vakovalskii/rc-pr-1/docs/photos/car.jpg

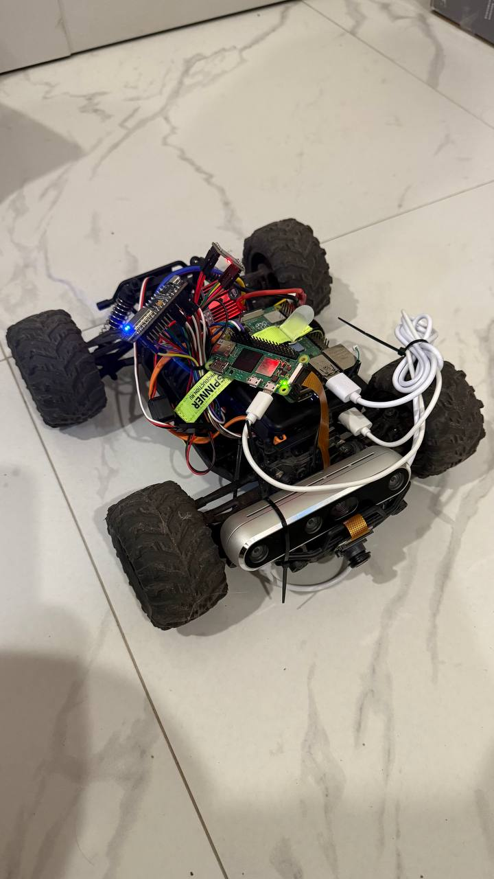
docs/photos/car.jpg
