vakovalskii/rc-pr-1/docs/photos/pult_osd_split.jpg

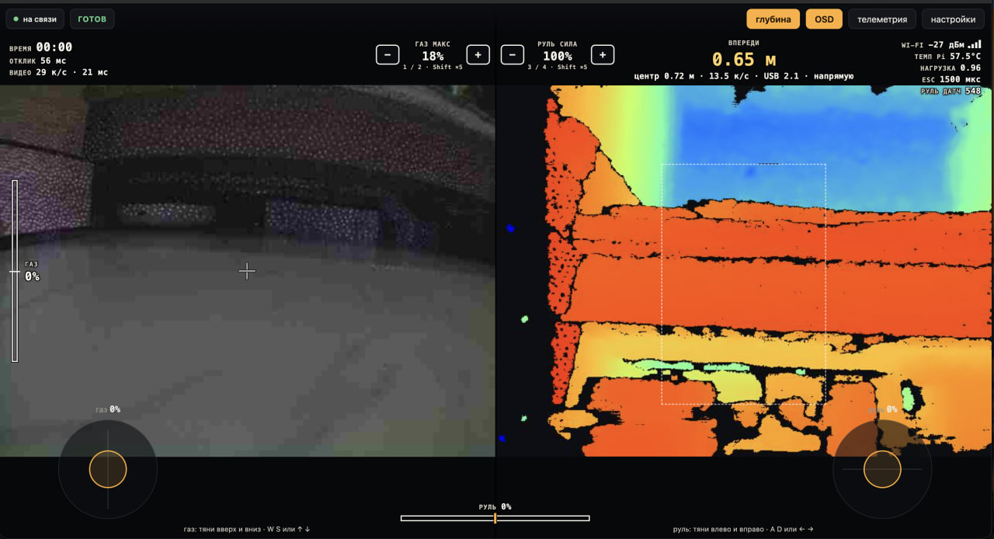
docs/photos/pult_osd_split.jpg
