vakovalskii/rc-pr-1/docs/BOM.md

# Железо: что есть и что покупаем

Цены и сроки — Ozon на 1 сентября 2026. Корзина собрана, заказ по частям.

## Что уже есть

| что | роль в проекте | заметки |
|---|---|---|
| Багги **HW8808RD** 1:16, 2.4 ГГц | шасси | родной пульт сломан, штатная плата выкидывается. 2 провода на коллекторный мотор. **Серва руля 5-проводная** (чёрный, красный, жёлтый, белый, коричневый): моторчик + потенциометр без своей электроники — напрямую ШИМ не понимает, нужен переходник 5→3 провода или замена на стандартную серву |
| Raspberry Pi 4 (4 ГБ по `free`) | голова на борту вместо Zero 2W | камера OV5647 160° в разъём CAMERA шлейфом из коробки камеры; питание 5.1 В 3 А, от BEC нельзя |
| Huawei 4G-модем с раздачей Wi-Fi | связь: едет **на машинке** | ESP32/Pi в 20 см от точки доступа, дальность = покрытие оператора. Разъём антенны (TS9 или CRC9) — посмотреть под крышкой |
| Mikrotik mAP lite | дома, не на борту | один радиомодуль не тянет одновременно точку доступа для ESP и станцию до модема |
| Mac mini (дом) + MacBook Pro M1 Pro 32 ГБ | хост вычислений, стенд | M1 Pro тянет COLMAP и обучение маленьких сетей; 3DGS лучше на 4090 |
| Парк GPU-серверов (2× 4090 48 ГБ ×2, 4090 24 ГБ, 2× A4500, 3080 Ti) | тяжёлое: сплаты, VLM | боевые машины под сервисами, занимать по договорённости |
| VPS с публичным IP | релей, если домашний интернет за CGNAT | |
| Телефон | экран пульта (веб-приложение) | на машинку не ставится |
| Паяльник | | канифоль и пинцет — в корзине |

## Корзина Ozon — 17 позиций, 22 869 ₽

| # | что | цена | приезд | зачем |
|---|---|---|---|---|
| 1 | ESP32-CAM с внешней антенной + плата-программатор USB | 1 176 ₽ | 3 сент | первый мозг: MJPEG-стрим и ШИМ; потом — реалтайм-контроллер моторов по UART от Pi |
| 2 | ESC **HG1060** 60A, brushed, реверс, BEC 5.35 В/3 А, T-plug | 1 182 ₽ | 7 сент | ходовой регулятор; BEC питает серву и ESP |
| 3 | Аккумулятор Li-ion 7.4 В 5000 мАч, T-plug | 1 422 ₽ | 2 сент | ходовая батарея |
| 4 | Зарядное B3 Pro балансирное | 945 ₽ | 2 сент | под ходовую батарею |
| 5 | Raspberry Pi Zero 2 W | 7 933 ₽ | 5 сент | второй этап: H.264 с CSI-камеры, WireGuard, GPS |
| 6 | Камера OV5647 CSI, 160° | 1 057 ₽ | 7 сент | для Pi; аппаратный H.264 работает только с CSI |
| 7 | Шлейф FFC под Pi Zero, 30 см | 376 ₽ | 7 сент | |
| 8 | microSD Samsung EVO Plus 64 ГБ (MB-MC64HA/RU), **A1** | 1 333 ₽ | 4 сент | под Pi; линуксу нужен A1, A2 бесполезен |
| 9 | microSD Smartbuy 32 ГБ Class 10 | 735 ₽ | 2 сент | под ESP (пишет JPEG подряд, A1 не нужен) |
| 10 | Корпус-повербанк DIY 4× 18650, 22.5 Вт, Type-C | 642 ₽ | 13 сент | питание Pi и модема **отдельно от BEC** |
| 11 | Банки 18650 30Q 3000 мАч × 4 | 1 752 ₽ | 4 сент | в повербанк; высокотоковость не нужна (0.5 А на банку) |
| 12 | GPS NEO-M8N | 1 133 ₽ | | для поля первичнее визуального SLAM |
| 13 | Набор: припой + пинцет + канифоль | 198 ₽ | 2 сент | |
| 14 | Провода Dupont 20 см, 120 шт | 210 ₽ | 2 сент | |
| 15 | Ящик СИБРТЕХ 21″ 530×290×280, органайзеры | 1 775 ₽ | 2 сент | внутри ~50×26×25 — багги влезает по ширине колёс |
| 16–17 | разъёмы XT60 мама-папа | | | питание на нормальном силовом стандарте |

Ошибка первого заказа: **ESC 30A за 809 ₽ — для бесколлекторных моторов авиамоделей**, в багги
коллекторный мотор с реверсом. Не использовать, заменён на HG1060.

## Проверить дома / докупить копеечное

| что | зачем | ~цена |
|---|---|---|
| Подставка под машинку | колёса в воздухе — калибровать газ и руль без побега со стола | 300 ₽ |
| Липучка-ремень для батареи | штатный держатель под другой аккумулятор | 150 ₽ |
| Стяжки + двусторонний скотч 3M VHB | крепить платы до печати корпуса | 300 ₽ |
| Термоусадка | единственная спайка на моторе | 200 ₽ |
| Мультиметр | прозвонить питание до первого включения | 800 ₽ |

## Потом, по результатам первых выездов

- Антенны для Huawei: TS9 5 dBi (237 ₽) или CRC9 3 dBi (235 ₽) — после 14 сентября, когда станет ясен разъём.
- Пигтейлы TS9→SMA (377 ₽) + выносные SMA-антенны, если машинку начнём ронять всерьёз.
- IMU MPU6050 (150 ₽) — GPS не знает курс стоя на месте, сращивать с гироскопом.
- 3D-печать корпуса под электронику.

## Ключевые распиновки и ограничения

- ESP32-CAM: после камеры и PSRAM свободны GPIO **13** и **14** — серва на 14, ESC на 13, ШИМ через аппаратный LEDC.
- SD-слот ESP32-CAM в 1-битном режиме занимает GPIO 2, 14, 15 — либо карта, либо два чистых ШИМ.
- Pi питать от повербанка, не от BEC: 5.35 В выше спеки USB, а серва просаживает шину.
- Pi Zero 2 W: хороший UART занят Bluetooth, для GPS нужен `dtoverlay=disable-bt`.
- GPS-антенну подальше от LTE-модема — гармоники глушат сигнал −130 дБм.
- Довесок на шасси ~700–790 г при собственном весе ~1 кг: тяжёлое низко и между осями.
