vakovalskii/rc-pr-1/docs/wiring/README.md

# Проводка борта: Pi Zero 2 W + ESP8266 + DRV8837

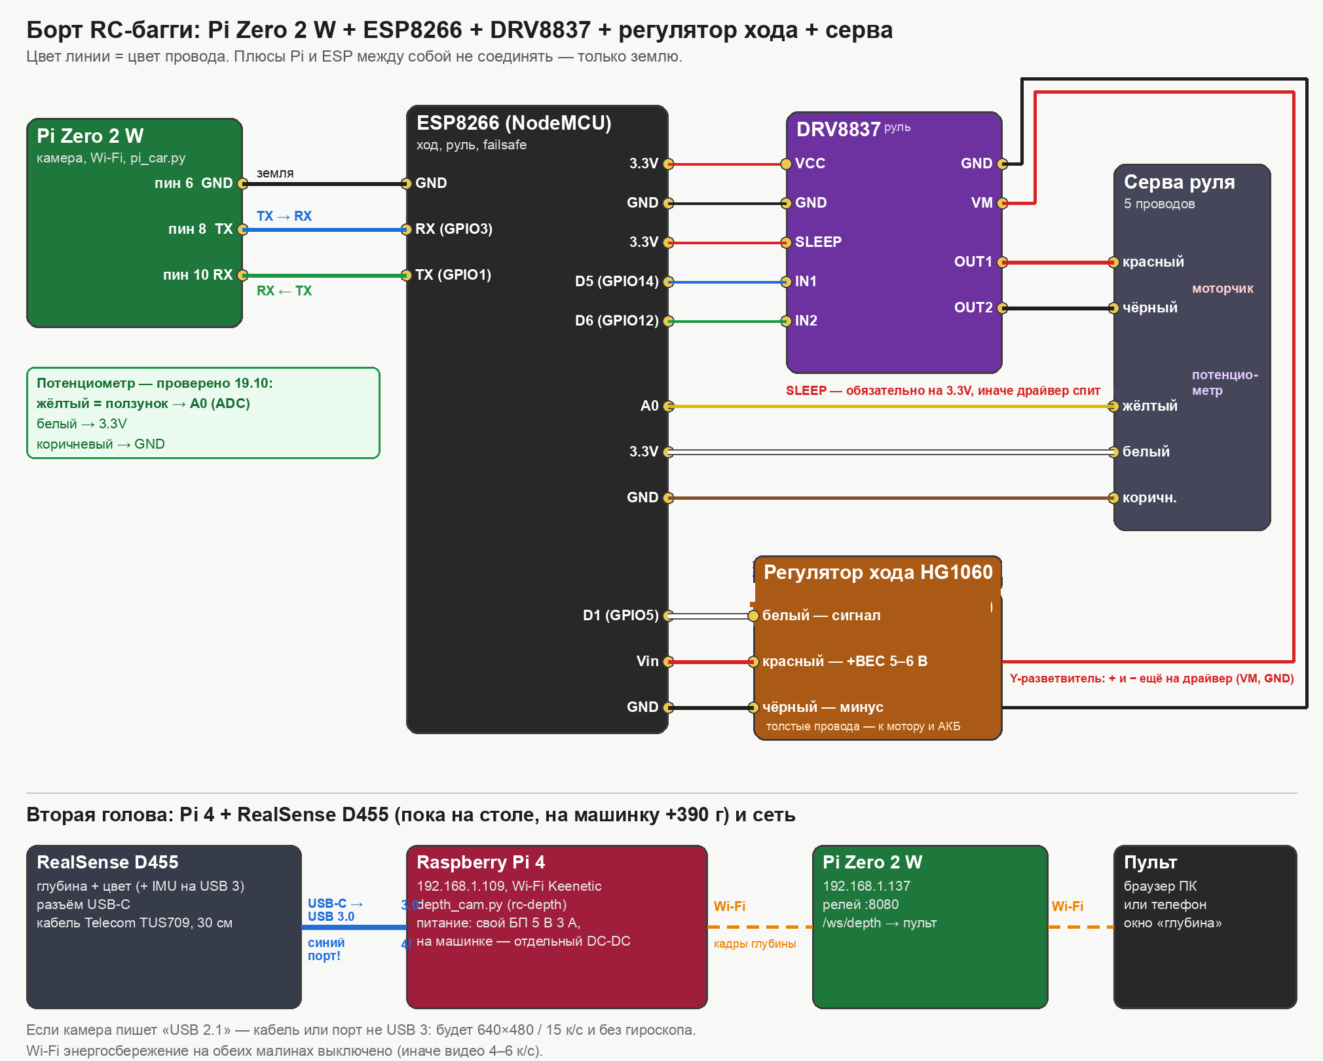
[picture p4: docs/wiring/board_full.png]
Общая схема


Pi Zero 2 W — камера и сеть. ESP8266 (NodeMCU, `firmware/rc_esp`) — ход, руль по
потенциометру и failsafe 300 мс. Связь между ними — UART, команды `c,id,руль,газ`.

## Pi Zero 2 W → ESP8266 (UART)

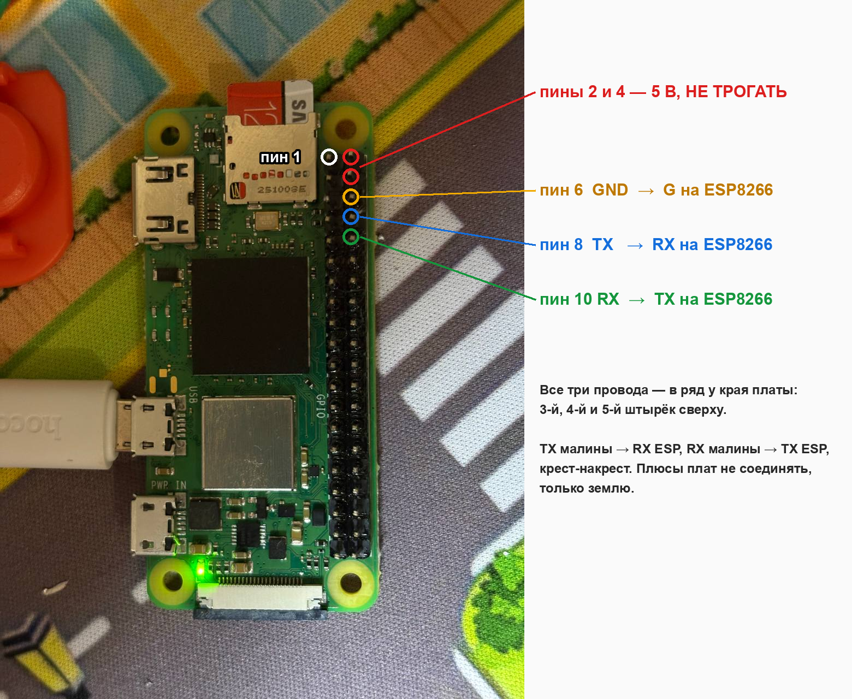
[picture p5: docs/wiring/pi_zero_uart.png]
Pi Zero

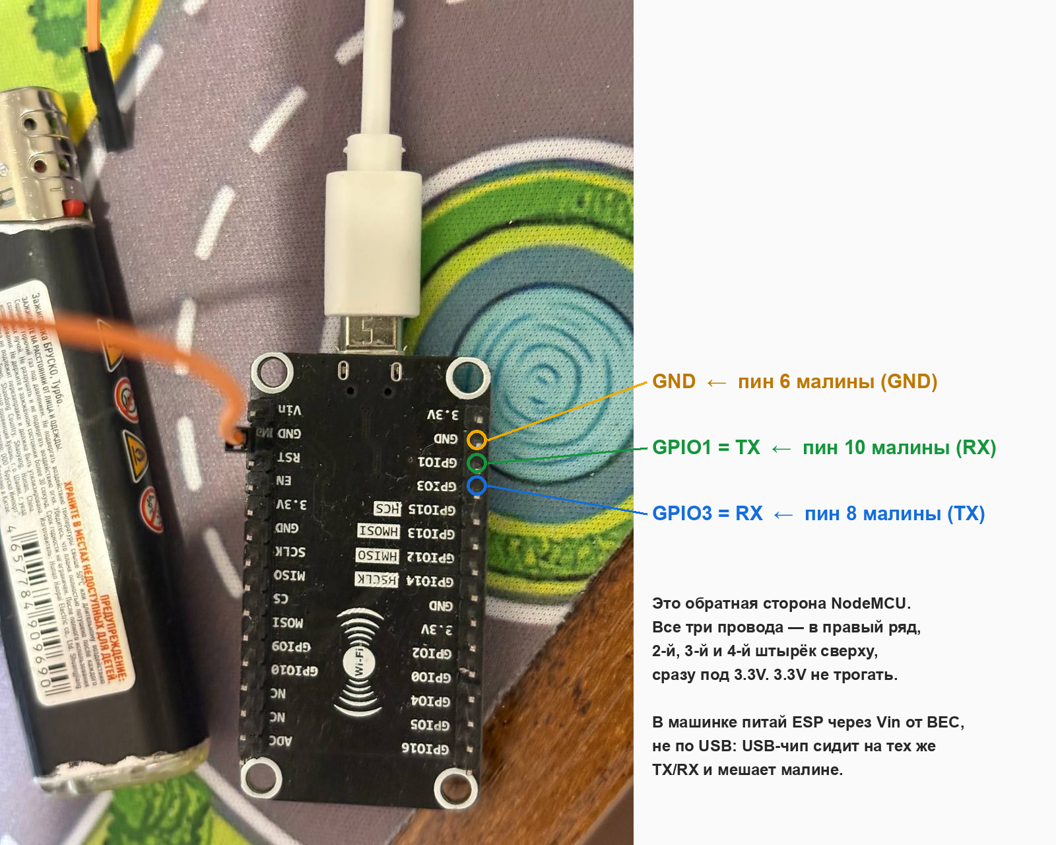
[picture p6: docs/wiring/esp_uart.png]
ESP8266, UART


| Pi Zero | ESP8266 |
|---|---|
| пин 6, GND | GND (правый ряд на обороте, 2-й сверху) |
| пин 8, GPIO14 TX | GPIO3 RX (4-й) |
| пин 10, GPIO15 RX | GPIO1 TX (3-й) |

На Zero: `enable_uart=1`, `dtoverlay=disable-bt`, консоль убрана из `cmdline.txt`,
порт `/dev/serial0 -> ttyAMA0`. Плюсы плат не соединяются, только земля.

## Регулятор хода (HG1060, 3 провода)

| Провод регулятора | Куда |
|---|---|
| белый — сигнал | GPIO5 / D1 ESP |
| красный — BEC +5–6 В | Vin ESP и VM драйвера |
| чёрный — минус | GND ESP и правый GND драйвера |

## Серва руля (5 проводов, своей электроники нет)

| Провод сервы | Что это | Куда |
|---|---|---|
| красный, чёрный | моторчик | OUT1, OUT2 драйвера |
| жёлтый | ползунок потенциометра | A0 (ADC) |
| белый | край потенциометра | 3.3V ESP |
| коричневый | край потенциометра | GND ESP |

## DRV8837 → ESP8266 и машинка

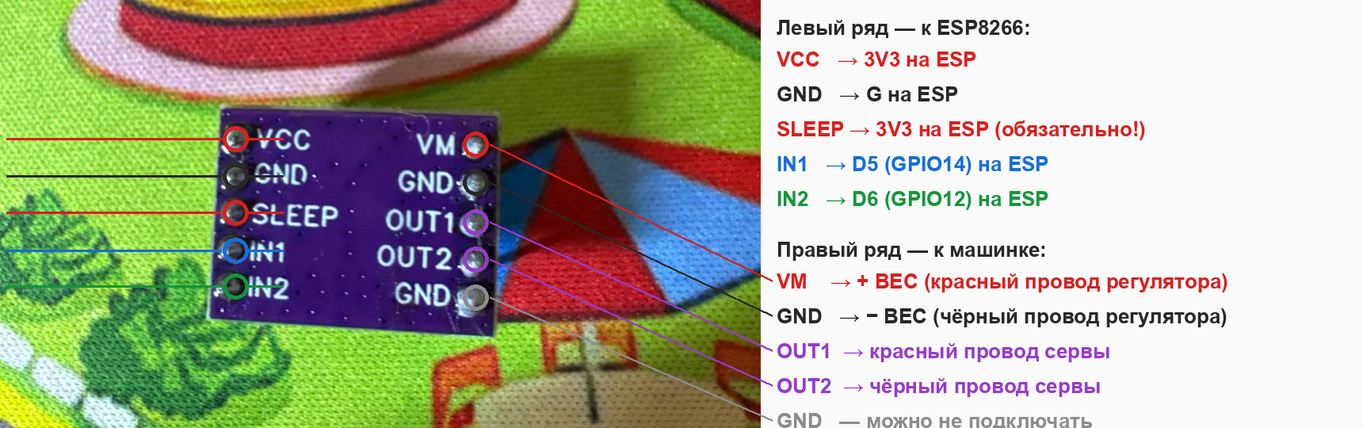
[picture p7: docs/wiring/drv8837_wiring.png]
DRV8837

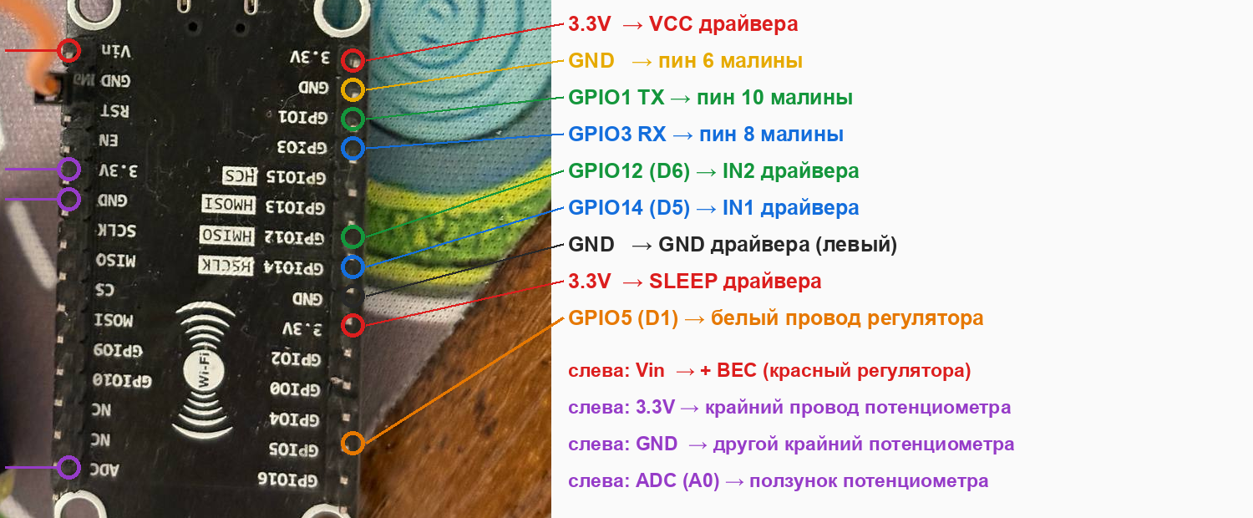
[picture p8: docs/wiring/esp_full_wiring.png]
ESP8266, всё


| DRV8837 | Куда |
|---|---|
| VCC | 3.3V ESP |
| GND (левый) | GND ESP |
| SLEEP | 3.3V ESP — без этого драйвер спит (на плате подтяжка к GND) |
| IN1 | D5 / GPIO14 |
| IN2 | D6 / GPIO12 |
| VM | + BEC регулятора (красный) |
| GND (правый) | − BEC регулятора (чёрный) |
| OUT1 / OUT2 | красный / чёрный провод сервы (полярность меняется командой `inv`) |

Потенциометр сервы (жёлтый/белый/коричневый): ползунок → A0 (ADC), крайние → 3.3V и GND.
Ползунок — тот провод, у которого сопротивление к двум другим меняется при повороте колёс.

ESP в машинке питается от BEC через Vin. По USB на столе — можно, но USB-чип NodeMCU
сидит на тех же TX/RX и может мешать малине.

## Фото

- `../photos/car.jpg` — машинка в сборе: Pi Zero 2 W + ESP8266 + DRV8837 сверху, Pi 4 под ними, RealSense D455 и OV5647 спереди.
- `../photos/pult_osd_split.jpg` — пульт: FPV слева (29 к/с, 21 мс), глубина справа напрямую с Pi 4, OSD с газом и рулём.
- `../photos/fpv_first_test.jpg` — первый тестовый кадр камеры Zero.

## Датчик Холла на задний кардан (одометрия)

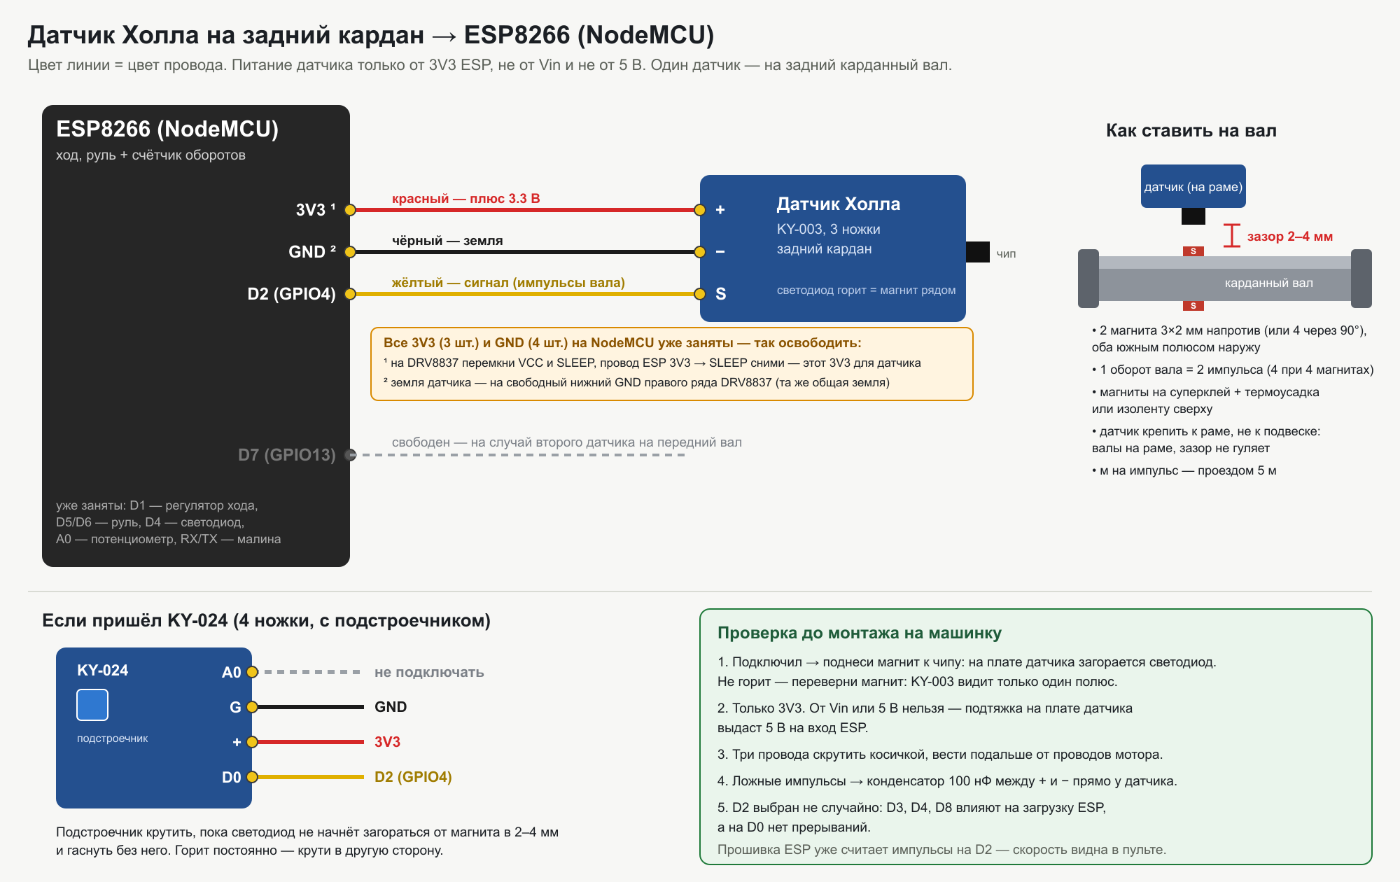
[picture p9: docs/wiring/hall_sensors.png]
Датчик Холла


| Датчик | Куда на ESP |
|---|---|
| + | 3V3 (только 3.3 В) |
| − | GND |
| S (KY-003) / D0 (KY-024) | D2 / GPIO4 (D7 / GPIO13 оставлен под второй датчик на передний вал) |

Два магнита 3×2 мм на задний кардан напротив друг друга (или 4 через 90°), южным полюсом наружу, зазор 2–4 мм — 2 (4) импульса на оборот.
