vakovalskii/rc-pr-1/docs/wiring/pi4_pins.html

# Pi 4: куда втыкать провода с Zero

Вид как на фото: Ethernet и USB слева, пин 1 справа. Нижний ряд — чётные пины, у края платы. Вентиляторы на 4 и 6 не трогать.

Схема гребёнки Pi 4 с подключением ESP8266, вентиляторов, BNO085 и GPS

Пин Pi 4 | Куда на ESP | Зачем
14 | GND | земля (пин 6 занят вентилятором)
8 | GPIO3 · RX | команды с Pi на ESP
10 | GPIO1 · TX | телеметрия с ESP на Pi
11 | RST | только для прошивки
13 | GPIO0 · D3 | только для прошивки

Питание ESP — от BEC регулятора (Vin), как было. Перетыкать при выключенном питании.
