vakovalskii/rc-pr-1/docs/wiring/esp_flash_via_zero.png

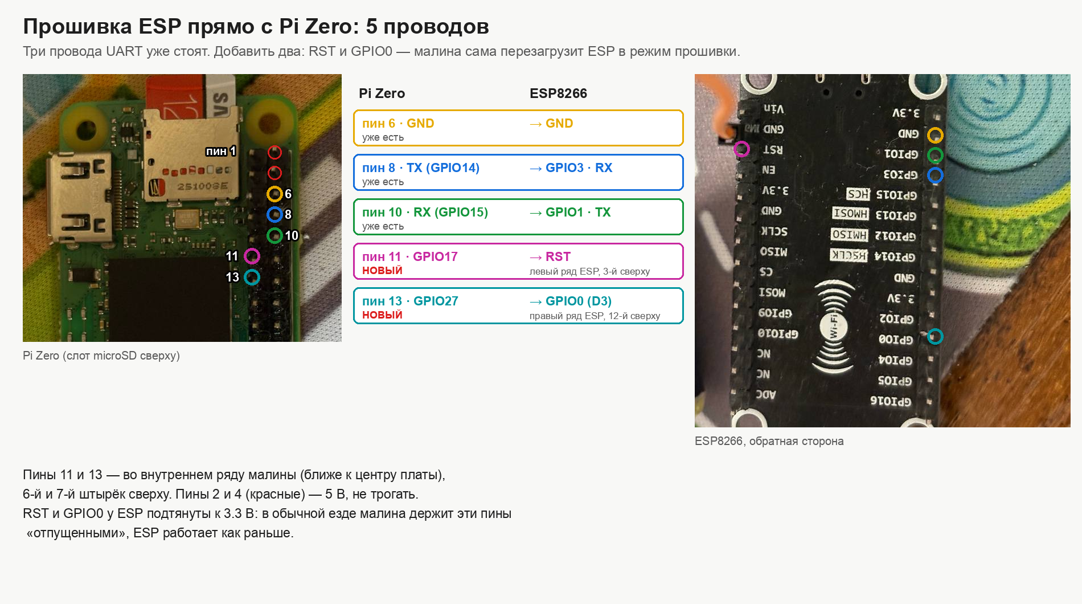
docs/wiring/esp_flash_via_zero.png
