vakovalskii/rc-pr-1/docs/wiring/pi4_pins.png

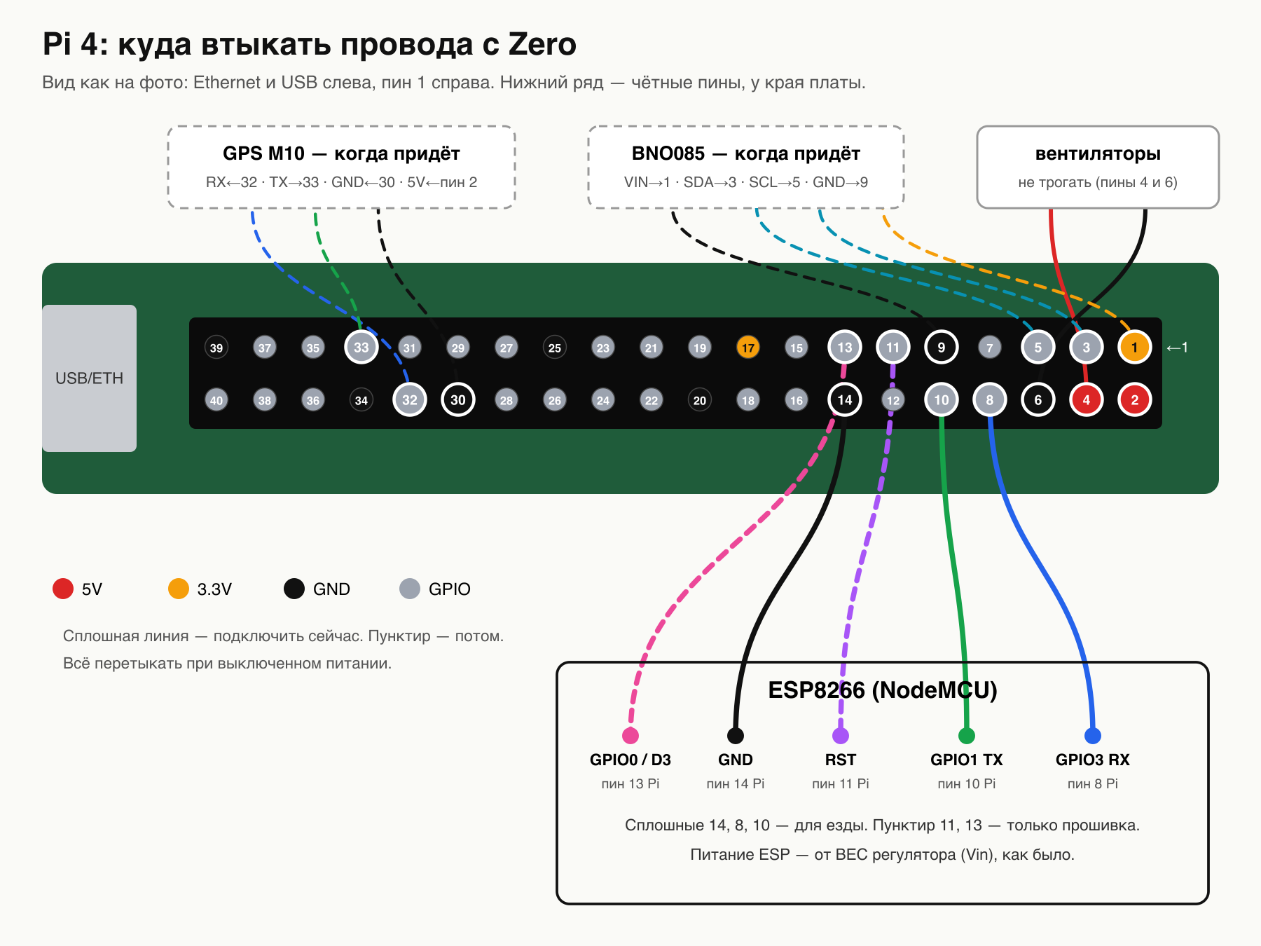
docs/wiring/pi4_pins.png
