vakovalskii/rc-pr-1/docs/wiring/pot_variants.png

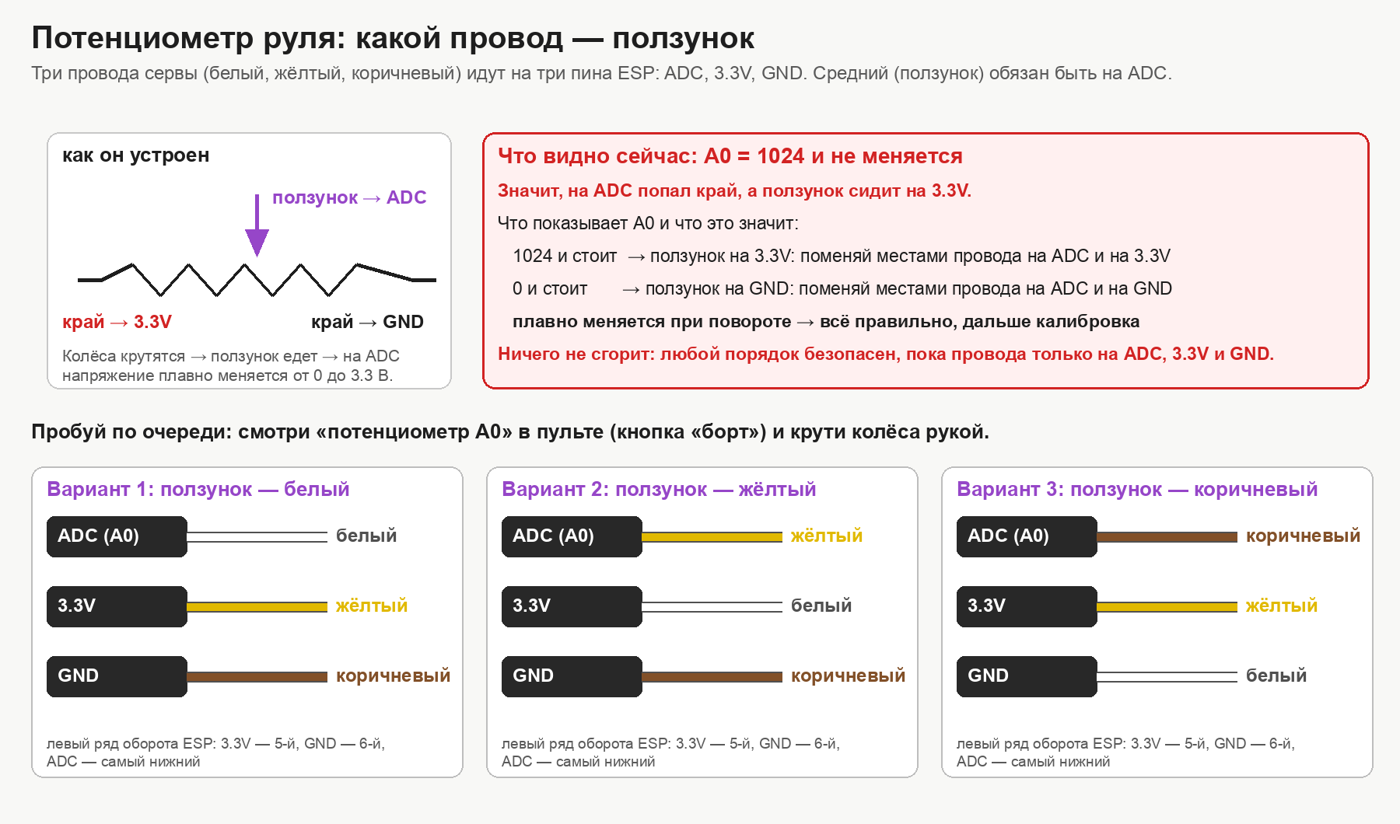
docs/wiring/pot_variants.png
