vakovalskii/rc-pr-1/docs/photos/fpv_first_test.jpg

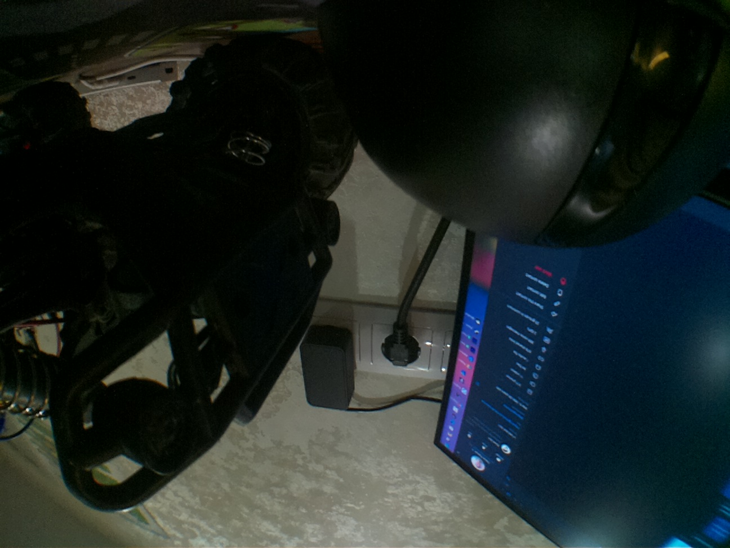
docs/photos/fpv_first_test.jpg
