vakovalskii/rc-pr-1/live_slam.py

"""
Живая 3D-карта и карта проходимости: берёт уменьшенные RGBD-пары прямо с Pi 4 (depth_cam.py --serve
--color), считает одометрию тем же трекером, что slam.py, и шлёт в релей новые точки, позу и сетку
«где можно ехать» — пульт (окно «3D-карта») и /map3d.html рисуют, как карта наполняется.

    uv run --python 3.12 --with open3d --with aiohttp --with pillow python live_slam.py

Новая карта — при старте и при каждом нажатии «запись 3D» в пульте; обрыв связи карту не сбрасывает.
Каждый сеанс целиком пишется в data/live-<время>/: raw/ (пары 320x240 — можно пересобрать slam.py)
и map/ (map.png + map.json в формате map_build.py). Релей кладёт последнюю сетку в свою папку карты.

Проходимость — сетка занятости 5 см с лог-шансами: точки на высоте корпуса (4–35 см над полом) —
препятствие, клетки по лучу от камеры до них — свободно, проеханный путь — свободно точно.
«Вверх»: пока машинка не разъехалась — по наклону камеры (--pitch), потом — по плоскости траектории.

Сообщения в релей (/ws/map3d):
  binary  b"P" + uint32 n + int16[n,3] (мм, мир первого кадра: x вправо, y вниз, z вперёд) + uint8[n,3] цвет
  binary  b"G" + uint32 len + json {res, origin, width, height, R (строки: e1, e2, вверх), floor} + PNG сетки
  text    {"type":"pose","up":[3],"T":[16],"kf":,"lost":,"jumps":,"pts":,"frames":,"fps":,"lag_ms":}
          {"type":"reset","rec":папка записи или null}
"""
import argparse, asyncio, io, json, math, pathlib, time
import numpy as np
import open3d as o3d
import aiohttp
from PIL import Image
from slam import Tracker
from scan2d import Grid, Scan2D, planar, pose_T

ROOT = pathlib.Path(__file__).parent

def decode(b):
    L = int.from_bytes(b[4:8], "little"); meta = json.loads(b[8:8 + L]); o = 8 + L
    Lz = int.from_bytes(b[o:o + 4], "little")
    return meta, b[o + 4:o + 4 + Lz], b[o + 4 + Lz:]

class Live:
    def __init__(self, a, freeze_up=False):
        self.a, self.freeze_up = a, freeze_up      # freeze_up: оси карты не поворачивать (автопилоту нужна неподвижная сетка)
        self.reset(None)

    def reset(self, rec):
        self.tr, self.cam_i, self.seen, self.pts, self.path, self.n, self.t0 = None, None, set(), 0, [], 0, time.time()
        self.traj_up = None; self.grid = Grid(self.a); self.grid_at = 0; self.times = []
        self.scan2d = None; self.match_scores = []
        self.imu_up = None; self.imu_ups = []; self.prev_yaw = None; self.prev_imu_yaw = None; self.imu_fix = 0
        self.dir = ROOT / "data" / f"live-{time.strftime('%Y%m%d-%H%M%S')}{'-' + rec if rec else ''}"
        (self.dir / "raw" / "depth").mkdir(parents=True, exist_ok=True); (self.dir / "raw" / "color").mkdir(exist_ok=True)
        print("сеанс:", self.dir)

    def rate(self):
        """к/с за последние ~20 кадров (время от запуска сюда не годится: машинка могла быть выключена)."""
        self.times.append(time.time()); self.times = self.times[-20:]
        return round((len(self.times) - 1) / max(self.times[-1] - self.times[0], 1e-3), 1) if len(self.times) > 1 else 0.0

    def up(self):
        if self.imu_up is not None: return self.imu_up          # гравитация из акселерометра D455 — лучше всего
        if self.traj_up is not None: return self.traj_up
        th = math.radians(self.a.pitch)                   # камера смотрит вверх на pitch: «вверх» в её системе
        return np.array([0, -math.cos(th), math.sin(th)])

    def process(self, meta, zpng, cjpg):
        """→ (кусок облака bytes или None, сетка bytes или None, поза dict)."""
        a = self.a
        z = np.asarray(Image.open(io.BytesIO(zpng)), np.uint16); rgb = np.asarray(Image.open(io.BytesIO(cjpg)).convert("RGB"))
        im = meta.get("imu") if getattr(a, "imu", True) else None
        if im and self.imu_up is None and 8 < im.get("g", 0) < 11.5:   # «вверх» — среднее по первым кадрам стоя (камера жёстко на шасси)
            self.imu_ups.append(np.asarray(im["up"], float))
            if len(self.imu_ups) >= 5 or self.tr is None:
                u = np.mean(self.imu_ups, 0); self.imu_up = u / np.linalg.norm(u)
        if self.tr is None:
            self.cam_i = o3d.camera.PinholeCameraIntrinsic(meta["w"], meta["h"], meta["fx"], meta["fy"], meta["cx"], meta["cy"])
            # одометрия на половине кадра (160x120) — в 4 раза быстрее, на Pi 4 это ~0.1 с вместо 0.4; облако — с полного кадра
            self.cam_o = o3d.camera.PinholeCameraIntrinsic(meta["w"] // 2, meta["h"] // 2, meta["fx"] / 2, meta["fy"] / 2, meta["cx"] / 2, meta["cy"] / 2)
            self.tr = Tracker(self.cam_o, a.depth_max, key_m=a.key_m, key_deg=a.key_deg)
            (self.dir / "raw" / "intrinsics.json").write_text(json.dumps({"width": meta["w"], "height": meta["h"], "fx": meta["fx"],
                "fy": meta["fy"], "cx": meta["cx"], "cy": meta["cy"], "depth_scale": meta["depth_scale"]}))
            self.grid.set_up(self.up())
        (self.dir / "raw" / "depth" / f"{self.n:06d}.png").write_bytes(zpng)
        (self.dir / "raw" / "color" / f"{self.n:06d}.jpg").write_bytes(cjpg)
        rgbd = o3d.geometry.RGBDImage.create_from_color_and_depth(
            o3d.geometry.Image(np.ascontiguousarray(rgb)), o3d.geometry.Image(np.ascontiguousarray(z)),
            depth_scale=1.0 / meta["depth_scale"], depth_trunc=a.depth_max, convert_rgb_to_intensity=False)
        rgbd_o = o3d.geometry.RGBDImage.create_from_color_and_depth(
            o3d.geometry.Image(np.ascontiguousarray(rgb[::2, ::2])), o3d.geometry.Image(np.ascontiguousarray(z[::2, ::2])),
            depth_scale=1.0 / meta["depth_scale"], depth_trunc=a.depth_max, convert_rgb_to_intensity=False)
        rot = None                                        # поворот с прошлого кадра по гироскопу — вокруг «вверх» в осях камеры
        if im and self.imu_up is not None and self.prev_imu_yaw is not None:
            rot = rot_axis(self.imu_up, math.radians(im["yaw"] - self.prev_imu_yaw))
        T, is_key = self.tr.step(rgbd_o, rot); self.n += 1
        if getattr(a, "planar", False):                   # машинка на полу: только x, y, курс — остальное ошибка одометрии
            T, (x, y, yaw) = planar(T, self.grid.R)
            # курс — по гироскопу всегда: камера в упор к стене (ближе 0.4 м D455 слепа) и на разворотах путает поворот,
            # гироскоп нет (дрейф ~2°/мин, его снимает подгонка по стенам ниже). imu_fix — сколько раз камера ошиблась больше 4°
            if im and self.prev_yaw is not None and self.prev_imu_yaw is not None:
                pred = self.prev_yaw + math.radians(im["yaw"] - self.prev_imu_yaw)
                if abs((yaw - pred + math.pi) % (2 * math.pi) - math.pi) > math.radians(4): self.imu_fix += 1
                yaw = pred
            if getattr(a, "scan", False):                 # и «пришпилить» кадр к 2D-карте, как лидар
                if self.scan2d is None: self.scan2d = Scan2D(self.grid.R, a.cam_height, (a.z_min, a.z_max), a.res, a.grid_m)
                pts = self.scan2d.scan(z.astype(np.float32) * meta["depth_scale"], meta["fx"], meta["fy"], meta["cx"], meta["cy"])
                lost = self.tr.miss > 0 or self.n - getattr(self, "lost_at", -99) < 5   # одометрия только что срывалась — ищем шире
                if self.tr.miss > 0: self.lost_at = self.n
                x, y, yaw, sc = self.scan2d.match(pts, x, y, yaw, *((0.30, 12.0) if lost else ()))
                if sc is not None: self.match_scores.append(sc)
                T = pose_T(x, y, yaw, self.grid.R)
                self.scan2d.add(pts, x, y, yaw)
            else: T = pose_T(x, y, yaw, self.grid.R)
            self.tr.correct(T)
            self.prev_yaw = yaw; self.prev_imu_yaw = im["yaw"] if im else None
        self.path.append(T[:3, 3].copy())
        chunk = None
        if is_key:
            pc = o3d.geometry.PointCloud.create_from_rgbd_image(rgbd, self.cam_i, np.linalg.inv(T)).voxel_down_sample(a.voxel)
            xyz, col = np.asarray(pc.points), np.asarray(pc.colors)
            self.grid.add(T, xyz)
            k = np.floor(xyz / a.voxel).astype(np.int64)            # шлём только воксели, которых ещё не было
            keys = (k[:, 0] + 50000) * 10 ** 10 + (k[:, 1] + 50000) * 10 ** 5 + (k[:, 2] + 50000)
            new = np.array([q not in self.seen for q in keys.tolist()], bool)
            self.seen.update(keys[new].tolist())
            if new.any() and self.pts < a.max_points:          # предел: зритель и релей на Zero не резиновые
                mm = np.clip(xyz[new] * 1000, -32767, 32767).astype("<i2"); c8 = (col[new] * 255).astype(np.uint8)
                chunk = b"P" + int(new.sum()).to_bytes(4, "little") + mm.tobytes() + c8.tobytes()
                self.pts += int(new.sum())
        if not self.freeze_up and not getattr(a, "planar", False) and self.n % 10 == 0 and len(self.path) > 20:   # «вверх» по плоскости траектории (как в slam.py)
            P = np.array(self.path); ev, evec = np.linalg.eigh(np.cov((P - P.mean(0)).T))
            if ev[2] > 0.3 ** 2 and ev[1] > 0.15 ** 2 and ev[0] < 0.03 ** 2:
                self.traj_up = evec[:, 0] * (1 if evec[1, 0] < 0 else -1); self.grid.set_up(self.traj_up)
        grid = None
        if self.grid.dirty and time.time() - self.grid_at > 1.0:
            gm, png = self.grid.render(self.tr.poses[::5])
            if gm:
                (self.dir / "map").mkdir(exist_ok=True)
                (self.dir / "map" / "map.png").write_bytes(png); (self.dir / "map" / "map.json").write_text(json.dumps(gm))
                js = json.dumps(gm).encode(); grid = b"G" + len(js).to_bytes(4, "little") + js + png
            self.grid.dirty, self.grid_at = False, time.time()
        tr = self.tr
        pose = {"type": "pose", "up": self.up().round(4).tolist(), "T": T.reshape(-1).round(4).tolist(), "kf": int(is_key),
                "lost": tr.lost, "jumps": tr.jumps, "imu_fix": self.imu_fix, "imu": self.imu_up is not None, "pts": self.pts, "frames": self.n,
                "fps": self.rate(), "lag_ms": round((time.time() - meta["t"]) * 1000)}
        return chunk, grid, pose

def rot_axis(u, ang):
    """Поворот на ang (рад) вокруг единичной оси u, против часовой, если смотреть с конца u (Родриг)."""
    K = np.array([[0, -u[2], u[1]], [u[2], 0, -u[0]], [-u[1], u[0], 0]])
    return np.eye(3) + math.sin(ang) * K + (1 - math.cos(ang)) * K @ K

async def depth_url(s, relay):
    async with s.ws_connect(f"{relay}/ws/depthview") as ws:
        async for m in ws:
            if m.type == aiohttp.WSMsgType.TEXT and '"depthsrc"' in m.data: return json.loads(m.data)["url"]

async def main(a):
    live, loop = Live(a), asyncio.get_running_loop()
    prev, announced = None, False
    async with aiohttp.ClientSession(trust_env=False) as s:
        while True:
            try:
                src = a.pi4 or await asyncio.wait_for(depth_url(s, a.relay), 10)
                async with s.ws_connect(src.replace("ws://", "http://"), max_msg_size=8 << 20) as cam, \
                           s.ws_connect(f"{a.relay}/ws/map3d", max_msg_size=32 << 20) as out:
                    await cam.send_str(json.dumps({"type": "raw"}))
                    print(f"камера {src} → релей {a.relay}/ws/map3d")
                    if not announced:                                # первая связь в этом запуске — чистый лист у зрителей
                        await out.send_str(json.dumps({"type": "reset", "rec": None})); announced = True
                    latest, ev = {"b": None}, asyncio.Event()

                    async def rx():                                  # держим только свежую пару — не копим очередь
                        async for m in cam:
                            if m.type == aiohttp.WSMsgType.BINARY and m.data[:4] == b"RGBD": latest["b"] = m.data; ev.set()
                    rt = asyncio.create_task(rx())
                    try:
                        while not rt.done():
                            try: await asyncio.wait_for(ev.wait(), 5)
                            except asyncio.TimeoutError: raise ConnectionError("5 с без кадров с Pi 4")
                            ev.clear(); meta, zpng, cjpg = decode(latest["b"])
                            cur = meta.get("rec")                            # папка записи на Pi 4 или None
                            if cur and cur != prev:                          # нажали «запись 3D» — новая карта
                                live.reset(cur); await out.send_str(json.dumps({"type": "reset", "rec": cur})); print("новая карта", cur)
                            prev = cur
                            chunk, grid, pose = await loop.run_in_executor(None, live.process, meta, zpng, cjpg)
                            if chunk: await out.send_bytes(chunk)
                            if grid: await out.send_bytes(grid)
                            await out.send_str(json.dumps(pose))
                            if live.n % 20 == 0:
                                print(f"кадров {live.n}, точек {live.pts}, потеряно {pose['lost']}, {pose['fps']} к/с, задержка {pose['lag_ms']} мс")
                    finally: rt.cancel()
            except Exception as e:
                print(f"нет связи ({e.__class__.__name__}: {e}), карта сохраняется, повтор через 2 с"); await asyncio.sleep(2)

if __name__ == "__main__":
    p = argparse.ArgumentParser()
    p.add_argument("--relay", default="http://raspberrypi.local:8080")
    p.add_argument("--pi4", help="адрес depth_cam, например ws://192.168.1.109:8090/ (по умолчанию спросить у релея)")
    p.add_argument("--voxel", type=float, default=0.04, help="м, шаг облака для показа")
    p.add_argument("--depth-max", type=float, default=2.5, help="м, дальше глубина D455 шумит и мажет карту")
    p.add_argument("--key-m", type=float, default=0.08)
    p.add_argument("--key-deg", type=float, default=8)
    p.add_argument("--pitch", type=float, default=25, help="°, на сколько камера смотрит вверх (пока нет траектории)")
    p.add_argument("--cam-height", type=float, default=0.10, help="м, высота RealSense над полом")
    p.add_argument("--z-min", type=float, default=0.04, help="м, ниже — пол")
    p.add_argument("--z-max", type=float, default=0.35, help="м, выше — не мешает проехать")
    p.add_argument("--car-radius", type=float, default=0.15, help="м, полоса вокруг пути, которая точно свободна")
    p.add_argument("--max-points", type=int, default=1_500_000, help="больше точек в облако не шлём")
    p.add_argument("--no-planar", dest="planar", action="store_false", help="не ограничивать позу плоскостью пола")
    p.add_argument("--no-scan", dest="scan", action="store_false", help="без 2D-скан-матчинга")
    p.add_argument("--no-imu", dest="imu", action="store_false", help="не брать гравитацию и гироскоп D455")
    p.add_argument("--res", type=float, default=0.05, help="м, клетка сетки проходимости")
    p.add_argument("--grid-m", type=float, default=30, help="м, сторона сетки")
    asyncio.run(main(p.parse_args()))
