vakovalskii/rc-pr-1/(commit log)

2026-09-01 rc-pr-1: стенд с релеем, симулятором и веб-пультом
2026-09-01 Полигон из съёмки: COLMAP → карта → свободная езда → обучение → автопилот
    - synth_room.py: синтетическая комната с точными позами для проверки конвейера
    - recon.py: COLMAP-обёртка, позы в метрах, пол z=0, масштаб по высоте камеры
    или длине маршрута, вердикт по съёмке, сравнение с правдой
    - map_build.py: сетка занятости из облака точек + план для глаз
    - polygon_car.py: езда по карте со столкновениями, картинка — бли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
2026-09-01 Пульт: управление стрелками / WASD с клавиатуры, R — на старт
    Claude-Session: https://claude.ai/code/session_01BunXSNifQSgqVTPfCXKy4i
2026-09-01 Автопилот фоном: роль pilot в релее, перехват стрелками, stand.py pilot
    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
2026-09-01 Конусы в полигоне, среда без сна, параллельный сбор данных, панель обучения
    - polygon_car: своё время, рендер любого размера, конусы/коробки по геометрии
    камеры, скольжение при ударе, счётчики обнуляются при сбросе
    - expert.py: общий эксперт для релея и среды, объезд сдвигом цели, выезд из упора
    - env.py: полигон как среда (reset/step/награда), bench 1980 шагов/с, eval
    - gen_data.py: эксперт в N процессах, 18k кадров за 7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
    [auto_drive.py, env.py, expert.py, gen_data.py, map_build.py, pilot.py, polygon_car.py, relay.py]
2026-10-03 Борт на Raspberry Pi 4: камера, аппаратный ШИМ, failsafe, systemd
    Claude-Session: https://claude.ai/code/session_01JzYHMjLxU1x1NEXotjzt2z
    [pi_car.py]
2026-10-03 BOM: серва 5-проводная, Pi 4 вместо Zero
2026-10-03 Прошивка ESP8266: точка RC-BUGGY с пультом, USB-протокол для Pi, failsafe, руль 5-проводной сервы по потенциометру
    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
    [rc_esp.ino]
2026-10-03 ESP: captive portal (пульт выскакивает сам), пароль точки 12345678
    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
2026-10-03 ESP: пульт с видимыми джойстиками, рампа разгона/торможения, смена направления через нейтраль
    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
2026-10-03 Прошивка ESP32-CAM: видео MJPEG фоном пульта, ход с рампой, руль без датчика, фара
    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
2026-10-03 ESP32-CAM: видео по одному кадру в пути (без очереди), выбор разрешения и качества, команды сразу при движении джойстика
    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
2026-10-03 ESP32-CAM: уровень сигнала телефона в пульте
    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
2026-10-03 ESP32-CAM: вытеснение старых сокетов видео, авто-откат на поток, переключатель режима видео
    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
2026-10-03 ESP32-CAM: /jpg и /stream на разных серверах, без автопереключения, сторож видео, диагностика в USB
    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
2026-10-03 ESP32-CAM: видео по WebSocket — плата шлёт кадры сама, окно 2 кадра; повтор запуска камеры
    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
2026-10-03 pi_car: ход и руль через ESP8266 по USB (--esp), failsafe остаётся на ESP
    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
    [pi_car.py]
2026-10-19 Схемы проводки: Pi Zero 2 W ↔ ESP8266 по UART, DRV8837 и потенциометр руля
    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
2026-10-19 Проводка: регулятор хода и провода сервы
    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
2026-10-19 Общая схема борта с цветами проводов
    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
2026-10-19 Схема: подпись VCC драйвера; pi_car: --rotate180, автопоиск /dev/serial0
    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
2026-10-19 Pi Zero: пульт на борту, панель «борт» с телеметрией ESP и малины, настройки руля с пульта; pi_car без камеры не падает
    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
2026-10-19 Схема: варианты подключения потенциометра руля
    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
2026-10-19 Pi Zero: systemd-сервисы релея и борта
    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
2026-10-19 Пульт: геймпад, видимые джойстики; видео 6 Мбит/с
    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
2026-10-19 Релей: команды от пульта, который рулит, нули других вкладок не перебивают; короткий стоп сервисов
    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
2026-10-19 Схема: проверенные цвета потенциометра (жёлтый — ползунок)
    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
2026-10-19 Новый пульт: настройки газа и руля (максимум, разгон, торможение, экспо, сила руля), телеметрия в выдвижной панели; прошивка ESP: pwm/kp/minpwm с пульта; потолок газа перенесён на ESP
    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
2026-10-19 Пульт: OSD поверх видео как в FPV-очках (O — вкл/выкл), геймпад только после нажатия кнопки
    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
2026-10-19 OSD: быстрые регуляторы потолка газа и силы руля (1/2, 3/4), температура Pi отдельной строкой
    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
2026-10-19 Схема: прошивка ESP с Pi Zero (RST и GPIO0)
    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
2026-10-19 Схема прошивки: чистое фото ESP
2026-10-19 Прошивка ESP с Pi Zero по UART (RST/GPIO0 на GPIO17/27): firmware/flash_via_zero.sh
    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
2026-10-19 Камера глубины RealSense вторым окном в пульте: depth_cam.py на Pi 4 -> релей /ws/depth -> пульт; «впереди N м» по полосе курса
    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
2026-10-19 depth_cam: сторож 5 с без кадров и выход при сбое камеры, ожидание камеры и аппаратный сброс при старте; systemd без лимита перезапусков
    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
2026-10-19 Пульт: потолок газа и сила руля шагом 1% (Shift — 5%); схема: Pi 4 + RealSense и сеть
    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
2026-10-19 Видео: 30 к/с при 3 Мбит/с, релей и пульт выбрасывают кадры вместо очереди, задержка видео в пульте и на OSD
    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
2026-10-19 Глубина напрямую с Pi 4 в пульт (depth_cam --serve 8090), релей только подсказывает адрес: FPV с глубиной 13 мс медиана вместо ~1 с
    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
2026-10-19 Запись для SLAM в depth_cam (--color, флаг ~/rc/rec.on): глубина по цветной камере + цвет + интринсики; фото с машинки в docs/photos
    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
2026-10-19 Кнопка «запись 3D» в окне глубины: старт/стоп по прямому каналу к Pi 4, время и кадры в реальном времени; фото машинки и пульта в docs/photos
    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
2026-10-19 slam.py: запись RealSense -> RGBD-одометрия Open3D против ключевых кадров -> облако и позы в формате recon/ для map_build.py; «вверх» по плоскости траектории
    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
2026-10-19 Релей на Zero отдаёт карту из ~/rc/map (map.html и минимапа в пульте)
    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
2026-10-19 Живая 3D-карта: depth_cam отдаёт уменьшенные RGBD-пары подписчику, live_slam.py (мак) считает одометрию и шлёт точки через релей, /map3d.html (three.js) рисует облако, машинку и путь; новая карта при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
2026-10-20 Проходимость и один интерфейс: live_slam строит сетку занятости (лучи от камеры, высота корпуса), релей пишет её в папку карты; в пульте окно «глубина | 3D-карта»; карта не сбрасывается при обрыве, с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
2026-10-20 live_slam: к/с по последним кадрам
    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
2026-10-20 Пульт под iPhone 16: короткие подписи, компактные OSD и джойстики, окно карты с панелью под вкладками; при открытой карте джойстики — угловые зоны (карту можно крутить, не трогая руль); страницы без 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
2026-10-20 Трекер: шаг больше 25 см / 25° за кадр — ошибка, модель скорости сбрасывается (поза уплывала на 236 м); slam.py — наклон камеры как запасное «вверх»; пределы точек в live_slam и памяти кусков в релее
    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
2026-10-20 ESP: в ручном режиме отпустил руль — колёса сами в центр по потенциометру (после калибровки); знак удержания по направлению шкалы (L>R работает); калибровка L=927 C=559 R=231, minpwm 380
    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
2026-10-20 Автопилот-исследователь explore.py: SLAM + память препятствий из профиля глубины, дуги руля, разворот в три приёма, разбор заезда и правка параметров; depth_cam: профиль препятствий 16 секторов на вы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
2026-10-20 Автопилот-служба autopilot.py: фронтиры + Дейкстра/A* по стоимостной карте + pure pursuit, круг по кольцу от стен, «в точку»/«домой», команды и план в окне карты; задний ход двойным нажатием (тормоз 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
2026-10-20 Эфир: пульт берёт глубину напрямую только когда окно глубины на экране, картинка зрителям 8 к/с (Pi 4: 27 → 4 Мбит/с, пинг 260 → 58 мс); панель «обучение» в окне карты; ложный «человек взял управлени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
2026-10-20 SLAM без IMU: поза на плоскости пола (x, y, курс) и 2D-скан-матчинг «виртуального лидара» из глубины к накопленной карте; офлайн на записях: высота пути 0.44 → 0, потери 86 → 29, скачки 6 → 1; включе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
2026-10-20 Сеть модема NZT2: Zero по Wi-Fi (приоритет выше Keenetic), Pi 4 по USB; адреса по именам pizero2w.local / raspberrypi.local
    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
2026-10-20 ESP: активный тормоз при отпускании газа (импульс «назад» brake,<мкс>,<мс>, по умолчанию 150 мкс × 300 мс), поля тормоза в телеметрии; прошивка через Zero по имени pizero2w.local
    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
2026-10-20 Тормоз: регулятор «вперёд/назад» без тормоза — длительность импульса по оценке скорости из газа (полный разгон — brake_ms, короткий проезд — меньше); ползунки «тормоз: сила/время» в настройках пульта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
2026-10-20 ESP: смена направления без нейтральной паузы — дал назад на ходу вперёд, колёса сразу назад (это и есть тормоз), и наоборот
    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
2026-10-20 ESP: тормоз противоходом только по нажатию «назад» на ходу — сразу, без рампы, сила brake_us (может быть больше потолка газа) на brake_ms × оценка скорости, потом обычный задний ход; отпустил газ — н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
2026-11-01 Пульт из интернета через L2TP в офис: пароль на релее (--pass-file, страница входа, cookie 30 дней, свои сети без пароля), прямые потоки глубины и map3d через релей, опрос модема; Zero как USB-сетева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
2026-11-01 Автопилот: корпус 39 см — лучи глубины от камеры (cam_back отодвигает центр), езда рывками (pulse_on/off) под ~3 кадра/с SLAM на Pi 4, продолжение маршрута после обрыва связи, свежесть кадра глубины 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
2026-11-06 SLAM на одной камере + Холл: mono_slam.py — Depth Anything V2 на маке только для «пол / не пол», дальность до оснований препятствий геометрией (высота 12 см, наклон 13°) + нависания, медианы по кадра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
2026-11-06 Прогресс и версии машинки: docs/PROGRESS.md (v0 стенд → v1 ESP32-CAM → v2 Pi + ESP → v3 RealSense D455 → v4 одна камера + Холл + модели), цифры на 6 ноября, что дальше; ссылка из README
